alesimattia/OBD2-car_dashboard-OLED/DOCS/Screenshot 2026-03-24 112052.png

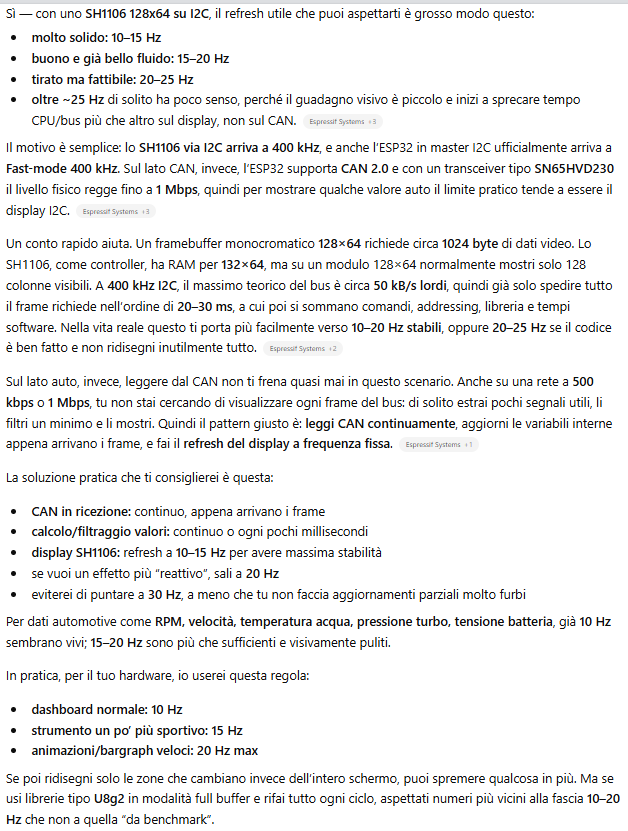
DOCS/Screenshot 2026-03-24 112052.png
