alesimattia/OBD2-car_dashboard-OLED/tools/DOCS/central_gateway_sniffer (2).png

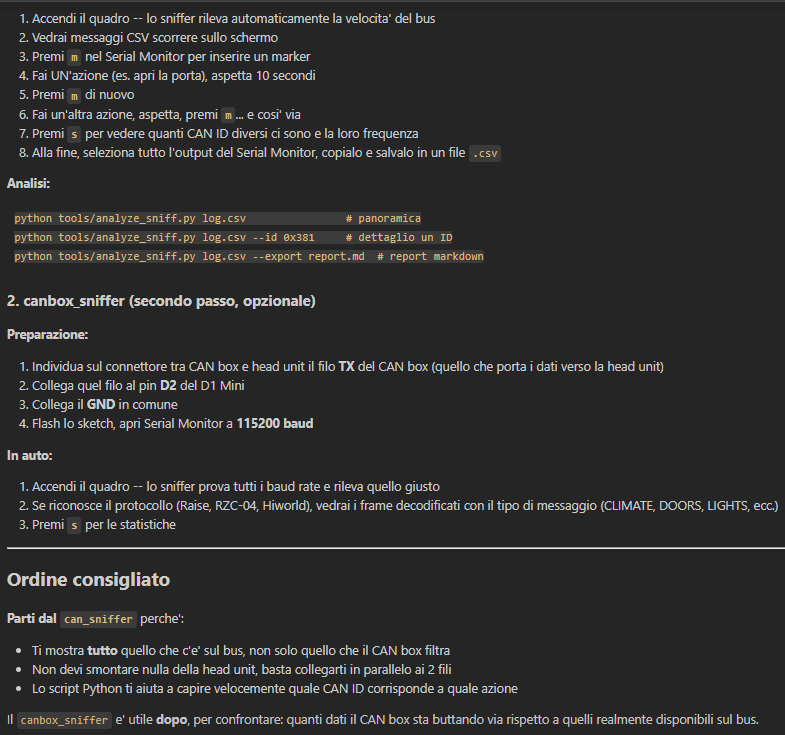
tools/DOCS/central_gateway_sniffer (2).png
