alesimattia/OBD2-car_dashboard-OLED/tools/DOCS/central_gateway_sniffer (4).png

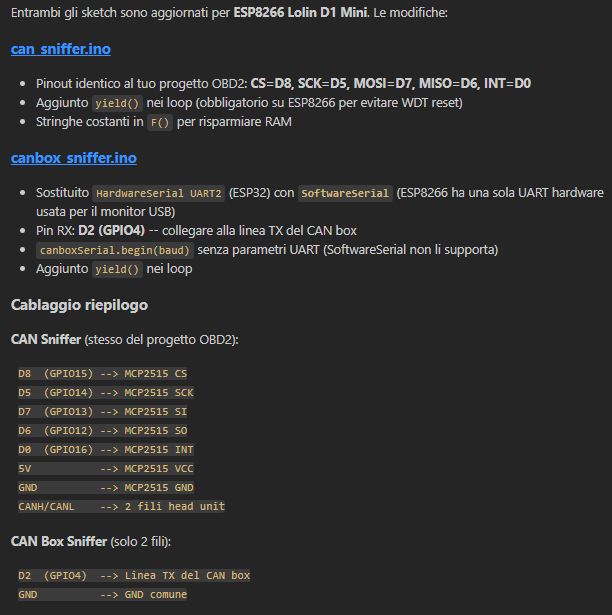
tools/DOCS/central_gateway_sniffer (4).png
