alesimattia/OBD2-car_dashboard-OLED/(commit log)

2026-03-23 Refactor for Arduino IDE
2026-03-26 Canbus readings speedup
2026-03-27 Extended PID range up to 0xFF
2026-03-30 PID scan
2026-03-31 Display EGR error percentage
    [CANbus_conn.ino, WIFI_conn.ino]
2026-04-01 Mobile Dashboard + Torque model
    - Added html dashboard via soft_AP to read ALL monitored and calculated data available.
    - Extensive and complete model to calculate torque based on available PID
2026-04-01 Rearranged files (fix constants)
    [BoostModel.h, EngineConstants.h, WIFI_conn.ino, web_dashboard.h]
2026-04-02 Fix models and layout
    [CANbus_conn.ino, WIFI_conn.ino]
2026-04-25 last val fix when error
    - aggiunta configurazione vscode
    [CANbus_conn.ino, WIFI_conn.ino]
2026-04-25 Phisical button - change page
2026-04-25 Light sensor - Auto dimming function
2026-04-28 Canbus sniffer
2026-04-30 Light sensor auto-calibration
2026-05-07 New Canbus PID (only discover, to implement reading) + supported PID dashboard
